pixelatedknight27/PIC18/README.md

# A PIC18 development board
### Based off of Professor Felix Pinai's ECE3301L board
