pixelatedknight27/PIC18/ExternFootprints/DILB40P-223TLF/PIC18F452-E_P.STEP

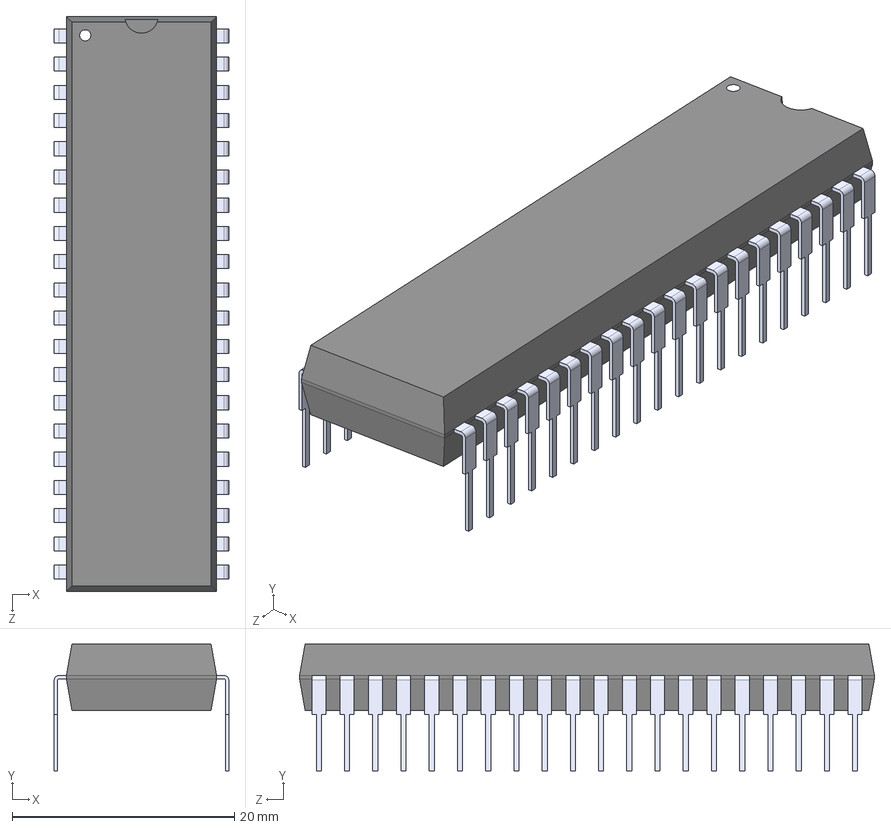
[picture p1: CAD file, 2024-06-22]
ExternFootprints/DILB40P-223TLF/PIC18F452-E_P.STEP
15.7 x 11.4 x 51.8 mm
