pixelatedknight27/PIC18/ExternFootprints/Jumpers/Jumper2-yellow.step

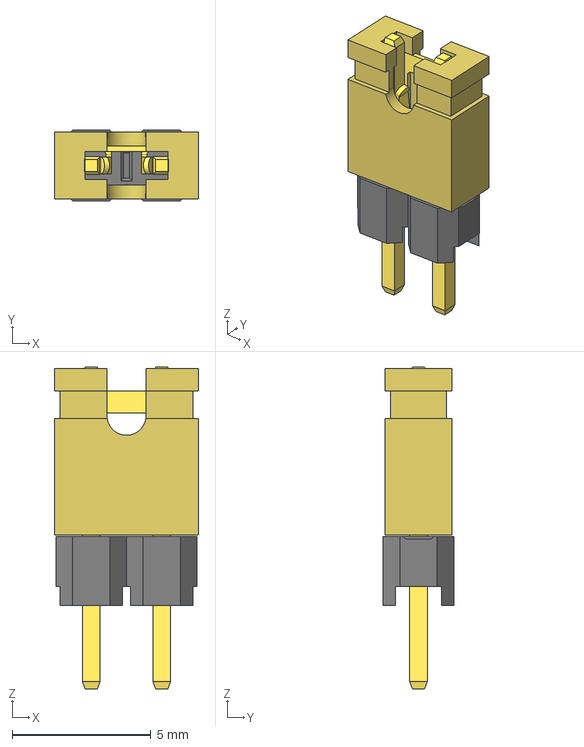
[picture p2: CAD file, 2024-06-23]
ExternFootprints/Jumpers/Jumper2-yellow.step
5.20 x 2.54 x 11.6 mm
