pixelatedknight27/PIC18/ExternFootprints/MF-MSMF200-2/MF-MSMF200-2.step

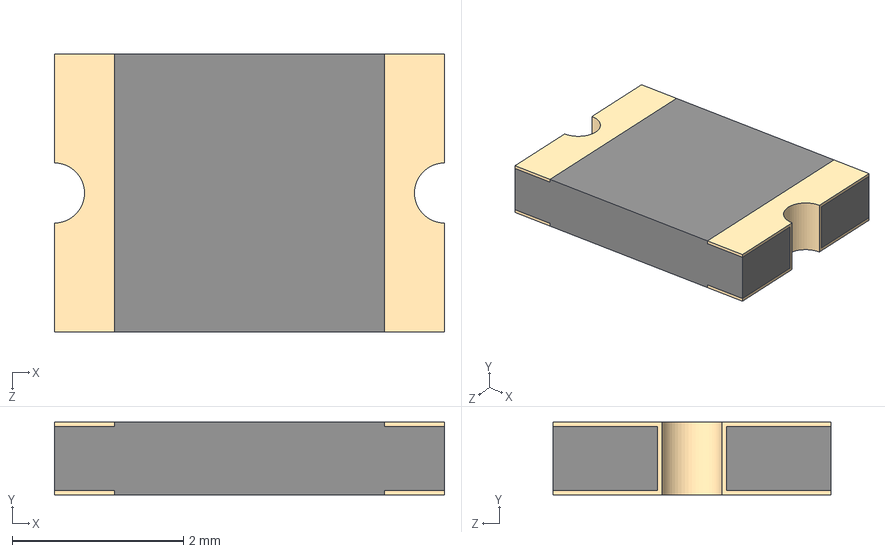
[picture p3: CAD file, 2024-06-23]
ExternFootprints/MF-MSMF200-2/MF-MSMF200-2.step
4.55 x 0.85 x 3.24 mm
