pixelatedknight27/PIC18/ExternFootprints/YC124-JR-071RL/YC124-JR-071RL.step

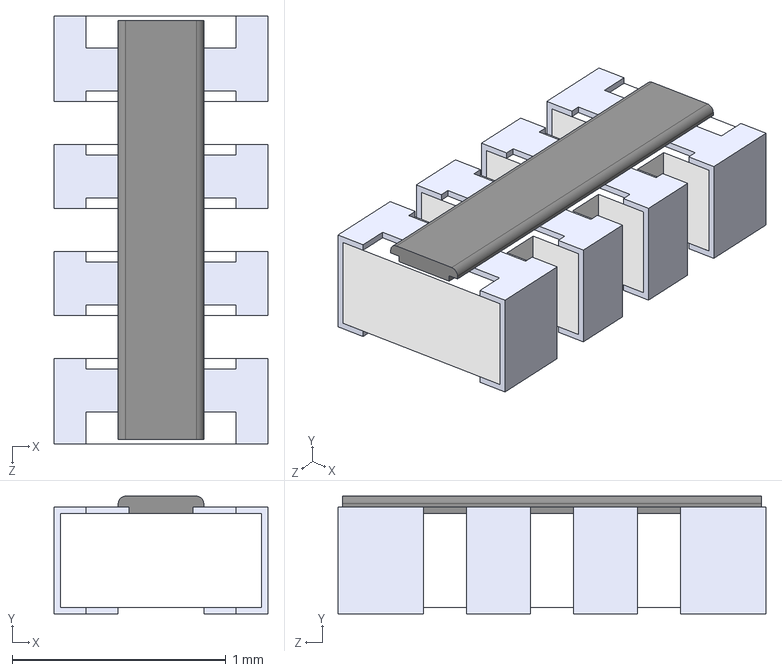
[picture p4: CAD file, 2024-07-10]
ExternFootprints/YC124-JR-071RL/YC124-JR-071RL.step
1.00 x 0.55 x 2.00 mm
