pixelatedknight27/PIC18/ExternFootprints/ZM4748A_L0G/ZM4748A_L0G.step

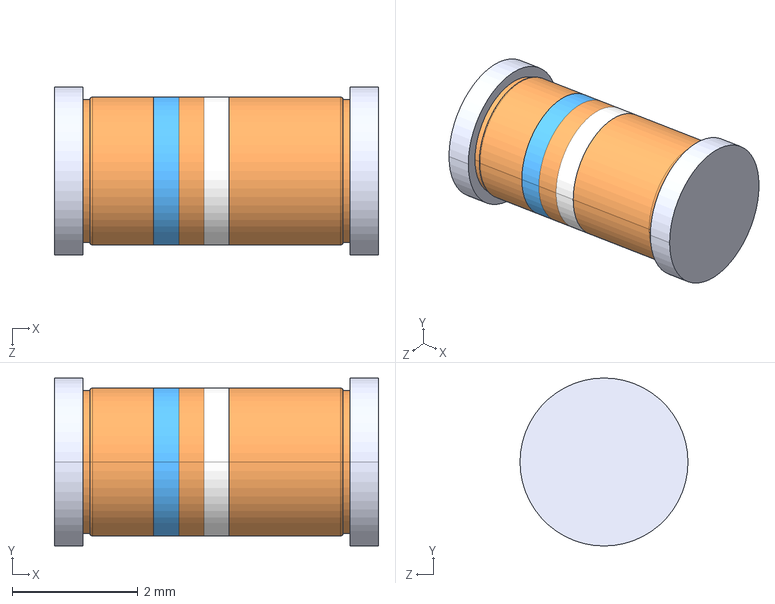
[picture p5: CAD file, 2024-06-23]
ExternFootprints/ZM4748A_L0G/ZM4748A_L0G.step
5.15 x 2.67 x 2.67 mm
