pixelatedknight27/PIC18/ExternFootprints/DILB40P-223TLF/DILB40P-223TLF.step

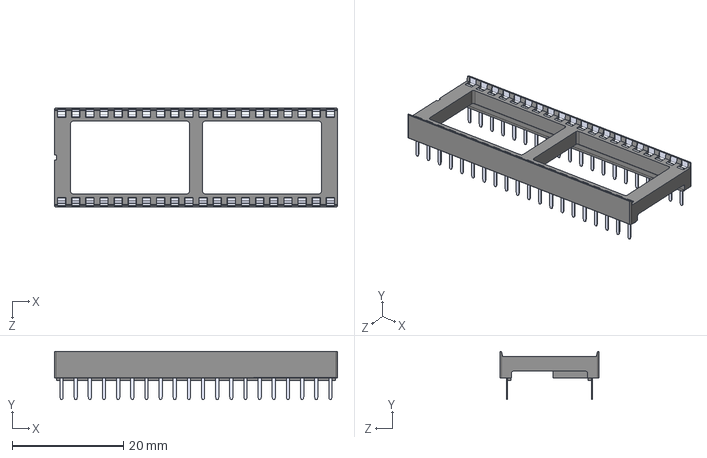
[picture p6: CAD file, 2024-06-22]
ExternFootprints/DILB40P-223TLF/DILB40P-223TLF.step
50.8 x 8.70 x 17.8 mm
