pixelatedknight27/PIC18/ExternFootprints/Jumpers/Jumper-blue.step

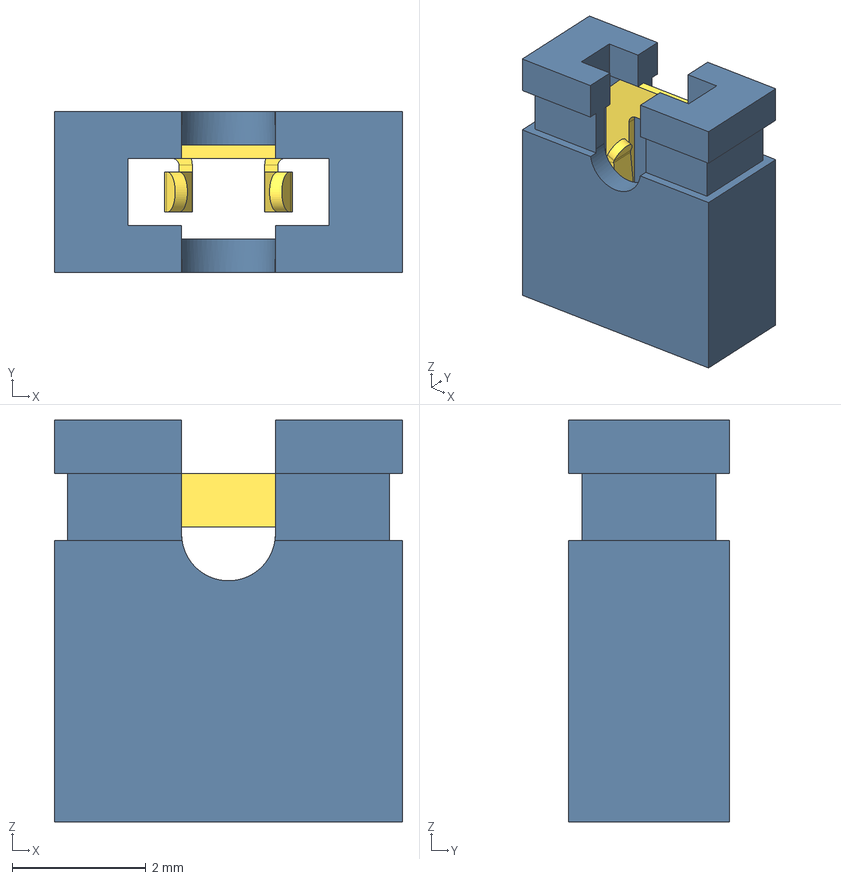
[picture p7: CAD file, 2024-06-23]
ExternFootprints/Jumpers/Jumper-blue.step
5.20 x 2.40 x 6.00 mm
