pixelatedknight27/PIC18/ExternFootprints/Jumpers/Jumper3-blue.step

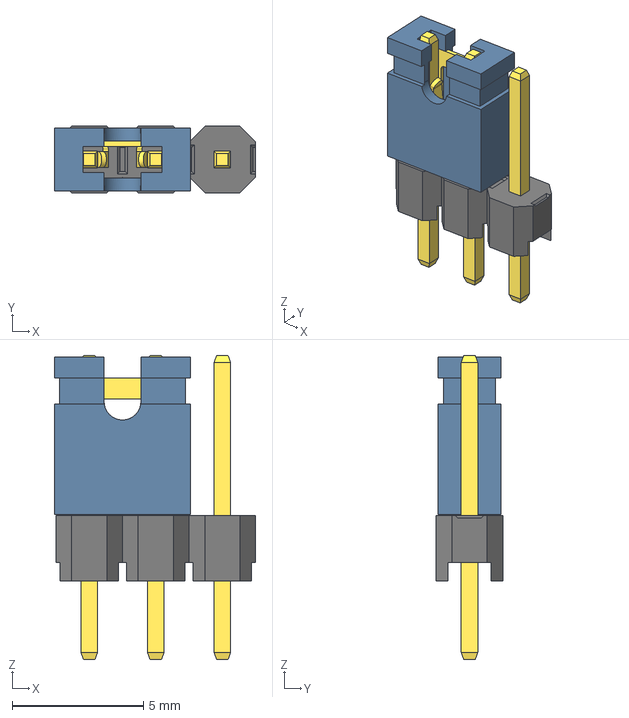
[picture p8: CAD file, 2024-06-23]
ExternFootprints/Jumpers/Jumper3-blue.step
7.68 x 2.54 x 11.6 mm
