pixelatedknight27/PIC18/(list of files, cad)

Other CAD files:
ExternFootprints/Jumpers/Jumper.step
ExternFootprints/Jumpers/Jumper-red.step
ExternFootprints/Jumpers/Jumper2.step
ExternFootprints/Jumpers/Jumper3.step
ExternFootprints/Jumpers/Jumper3-yellow.step
ExternFootprints/Jumpers/Jumper2-red.step
ExternFootprints/Jumpers/Jumper2-blue.step
ExternFootprints/Jumpers/Jumper-green.step
ExternFootprints/Jumpers/Jumper-yellow.step
ExternFootprints/Jumpers/Jumper2-green.step
ExternFootprints/Jumpers/Jumper3-green.step
ExternFootprints/Jumpers/Jumper3-red.step
ExternFootprints/MOLEX_105164-0001/105164-0001.step
ExternFootprints/ul_676433910/676433910.stp
