pixelatedknight27/PIC18/(list of files, drawings)

Other design files:
freerouting.dsn
