pixelatedknight27/PIC18/PIC18.kicad_pcb

## KiCad design PIC18.kicad_pcb (2024-08-14)

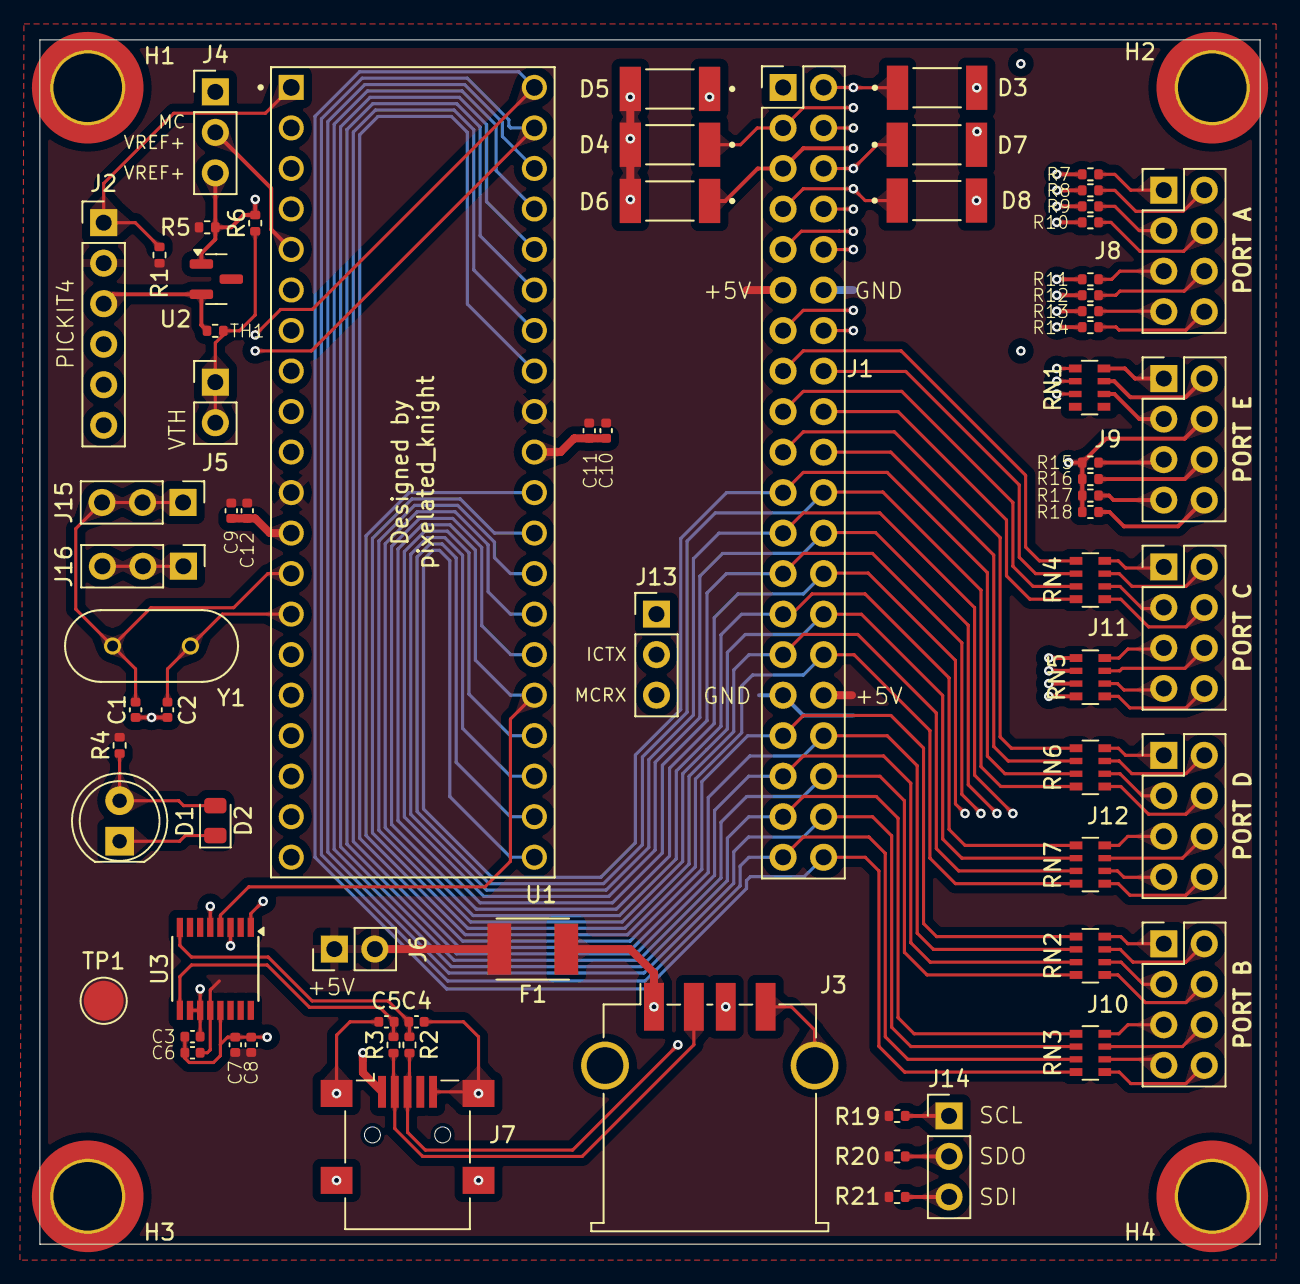
[picture p9: board PIC18.kicad_pcb from above]

Board: 4 copper layers, 76.5 x 75.5 mm, 75 parts (0 on the bottom side), 87 nets.

Parts:
C1, C2: 22pF; C_0402_1005Metric
C3, C6: 100nF; C_0402_1005Metric
C4, C5: 47pf; C_0402_1005Metric
C7: 4.7u; C_0402_1005Metric
C8, C10, C12: 100nf; C_0402_1005Metric
C9, C11: 1uf; C_0402_1005Metric
D1: LED; LED_D5.0mm
D2: LED; LED_0805_2012Metric
D3, D4, D5, D6, D7, D8: ZMM5V1; DIOMELF5124N
F1: MF-MSMF200-2; FUSER_MF-MSMF200-2
H1, H2, H3, H4: MountingHole_Pad; MountingHole_4.3mm_M4_ISO14580_Pad_TopBottom
J1: Conn_02x20_Odd_Even; PinSocket_2x20_Counter_Clockwise_P2.54mm_Vertical
J2: Conn_01x06; PinHeader_1x06_P2.54mm_Vertical
J3: USB_A; USB_A_TE_292303-7_Horizontal
J4, J13, J14, J15, J16: Conn_01x03; PinHeader_1x03_P2.54mm_Vertical
J5, J6: Conn_01x02; PinHeader_1x02_P2.54mm_Vertical
J7: USB_OTG; USB_Mini-B_Lumberg_2486_01_Horizontal
J8: Port A; PinHeader_2x04_P2.54mm_Vertical_Red
J9: Port E; PinHeader_2x04_P2.54mm_Vertical_Green
J10: Port B; PinHeader_2x04_P2.54mm_Vertical_Yellow
J11: Port C; PinHeader_2x04_P2.54mm_Vertical_Blue
J12: Port D; PinHeader_2x04_P2.54mm_Vertical_White
R1: 10K; R_0402_1005Metric
R2, R3, R5: 33; R_0402_1005Metric
R4, R6, R7, R8, R9, R10, R11, R12, R13, R14: 220; R_0402_1005Metric
R15: 100; R_0402_1005Metric
R16: 1k; R_0402_1005Metric
R17, R19, R20, R21: 10k; R_0402_1005Metric
R18: 100k; R_0402_1005Metric
RN1, RN2, RN3, RN4, RN5, RN6, RN7: 220; R_Array_Convex_4x0603
TH1: 10k; R_0402_1005Metric
TP1: TestPoint; TestPoint_Pad_D2.5mm
U1: PIC18F4620; AMPHENOL_DILB40P-223TLF
U2: LM4040DBZ-4.1; SOT-23
U3: FT230XS; SSOP-16_3.9x4.9mm_P0.635mm
Y1: 8 MHz; XTAL_HC49P488W43L1085T450H368

Connections:
/*MCLR/VPP/RE3: J1.1, J2.1, R1.2, U1.1 (*MCLR/VPP/RE3)
/OSC1/CLKI/RA7: C1.2, J1.13, J15.1, J15.2, J15.3, R13.1, U1.13 (OSC1/CLKI/RA7), Y1.2
/OSC2/CLKO/RA6: C2.2, J1.14, J16.1, J16.2, J16.3, R14.1, U1.14 (OSC2/CLKO/RA6), Y1.1
/RA0/AN0: D3.1 (K), J1.2, R7.1, U1.2 (RA0/AN0)
/RA1/AN1: D4.1 (K), J1.3, R8.1, U1.3 (RA1/AN1)
/RA2/AN2/VREF-/CVREF: D5.1 (K), J1.4, R9.1, U1.4 (RA2/AN2/VREF-/CVREF)
/RA3/AN3/VREF+: D6.1 (K), J1.5, J4.2, R10.1, U1.5 (RA3/AN3/VREF+)
/RA4/T0CKI/C1OUT: D7.1 (K), J1.6, R11.1, U1.6 (RA4/T0CKI/C1OUT)
/RA5/AN4/SS*/HLVDIN/C2OUT: D8.1 (K), J1.7, R12.1, U1.7 (RA5/AN4/SS*/HLVDIN/C2OUT)
/RB0/INT0/FLT0/AN12: J1.33, RN2.5 (R4.2), U1.33 (RB0/INT0/FLT0/AN12)
/RB1/INT1/AN10: J1.34, RN2.6 (R3.2), U1.34 (RB1/INT1/AN10)
/RB2/INT2/AN8: J1.35, RN2.7 (R2.2), U1.35 (RB2/INT2/AN8)
/RB3/AN9/CCP2(1): J1.36, RN2.8 (R1.2), U1.36 (RB3/AN9/CCP2(1))
/RB4/KBI0/AN11: J1.37, RN3.5 (R4.2), U1.37 (RB4/KBI0/AN11)
/RB5/KBI1/PGM: J1.38, RN3.6 (R3.2), U1.38 (RB5/KBI1/PGM)
/RB6/KBI2/PGC: J1.39, J2.5, RN3.7 (R2.2), U1.39 (RB6/KBI2/PGC)
/RB7/KBI3/PGD: J1.40, J2.4, RN3.8 (R1.2), U1.40 (RB7/KBI3/PGD)
/RC0/T1OSO/T13CKI: J1.15, RN4.5 (R4.2), U1.15 (RC0/T1OSO/T13CKI)
/RC1/T1OSI/CCP2(1): J1.16, RN4.6 (R3.2), U1.16 (RC1/T1OSI/CCP2(1))
/RC2/CCP1/P1A: J1.17, RN4.7 (R2.2), U1.17 (RC2/CCP1/P1A)
/RC3/SCK/SCL: J1.18, J14.1, R19.2, RN4.8 (R1.2), U1.18 (RC3/SCK/SCL)
/RC4/SDI/SDA: J1.23, J14.3, R21.2, RN5.5 (R4.2), U1.23 (RC4/SDI/SDA)
/RC5/SDO: J1.24, J14.2, R20.2, RN5.6 (R3.2), U1.24 (RC5/SDO)
/RC6/TX/CK: J1.25, RN5.7 (R2.2), U1.25 (RC6/TX/CK), U3.4 (RXD)
/RC7/RX/DT: J1.26, J13.3, RN5.8 (R1.2), U1.26 (RC7/RX/DT)
/RD0/PSP0: J1.19, RN6.5 (R4.2), U1.19 (RD0/PSP0)
/RD1/PSP1: J1.20, RN6.6 (R3.2), U1.20 (RD1/PSP1)
/RD2/PSP2: J1.21, RN6.7 (R2.2), U1.21 (RD2/PSP2)
/RD3/PSP3: J1.22, RN6.8 (R1.2), U1.22 (RD3/PSP3)
/RD4/PSP4: J1.27, RN7.5 (R4.2), U1.27 (RD4/PSP4)
/RD5/PSP5/P1B: J1.28, RN7.6 (R3.2), U1.28 (RD5/PSP5/P1B)
/RD6/PSP6/P1C: J1.29, RN7.7 (R2.2), U1.29 (RD6/PSP6/P1C)
/RD7/PSP7/P1D: J1.30, RN7.8 (R1.2), U1.30 (RD7/PSP7/P1D)
/RE0/RD*/AN5: J1.8, RN1.5 (R4.2), U1.8 (RE0/RD*/AN5)
/RE1/WR*/AN6: J1.9, RN1.6 (R3.2), U1.9 (RE1/WR*/AN6)
/RE2/CS*/AN7: J1.10, RN1.7 (R2.2), U1.10 (RE2/CS*/AN7)
/TXD: J13.2, U3.1 (TXD)
/VREF+: J4.3, J9.4, R5.2, R6.2, R15.1, R16.1, R17.1, R18.1, U2.1 (K)
/VTHERM: J5.1, J5.2, R6.1, TH1.1
GND: C1.1, C2.1, C3.2, C4.2, C5.2, C6.2, C7.2, C8.1, C9.1, C10.1, C11.1, C12.1, D1.1 (K), D2.1 (K), D3.2 (A), D4.2 (A), D5.2 (A), D6.2 (A), D7.2 (A), D8.2 (A), H1.1, H2.1, H3.1, H4.1, J1.12, J1.31, J2.3, J3.4 (GND), J3.5 (Shield), J7.5 (GND), J7.6 (Shield), TH1.2, U1.12 (VSS), U1.31 (VSS), U2.2 (A), U3.5 (GND), U3.13 (GND)
unnamed: D1.2 (A), D2.2 (A), R4.1
unnamed: J3.3 (D+), J7.3 (D+), R2.1
unnamed: J3.2 (D-), J7.2 (D-), R3.1
unnamed: F1.1, J3.1 (VBUS), J7.1 (VBUS)
unnamed: J8.1, R7.2
unnamed: J8.2, R8.2
unnamed: J8.3, R9.2
unnamed: J8.4, R10.2
unnamed: J8.5, R11.2
unnamed: J8.6, R12.2
unnamed: J8.7, R13.2
unnamed: J8.8, R14.2
unnamed: J9.1, RN1.4 (R4.1)
unnamed: J9.2, RN1.3 (R3.1)
unnamed: J9.3, RN1.2 (R2.1)
unnamed: J9.5, R15.2
unnamed: J9.6, R16.2
unnamed: J9.7, R17.2
unnamed: J9.8, R18.2
unnamed: J10.1, RN2.4 (R4.1)
unnamed: J10.2, RN2.3 (R3.1)
unnamed: J10.3, RN2.2 (R2.1)
unnamed: J10.4, RN2.1 (R1.1)
unnamed: J10.5, RN3.4 (R4.1)
unnamed: J10.6, RN3.3 (R3.1)
unnamed: J10.7, RN3.2 (R2.1)
unnamed: J10.8, RN3.1 (R1.1)
unnamed: J11.1, RN4.4 (R4.1)
unnamed: J11.2, RN4.3 (R3.1)
unnamed: J11.3, RN4.2 (R2.1)
unnamed: J11.4, RN4.1 (R1.1)
unnamed: J11.5, RN5.4 (R4.1)
unnamed: J11.6, RN5.3 (R3.1)
unnamed: J11.7, RN5.2 (R2.1)
unnamed: J11.8, RN5.1 (R1.1)
unnamed: J12.1, RN6.4 (R4.1)
unnamed: J12.2, RN6.3 (R3.1)
unnamed: J12.3, RN6.2 (R2.1)
unnamed: J12.4, RN6.1 (R1.1)
unnamed: J12.5, RN7.4 (R4.1)
unnamed: J12.6, RN7.3 (R3.1)
unnamed: J12.7, RN7.2 (R2.1)
unnamed: J12.8, RN7.1 (R1.1)
unnamed: C3.1, U3.3 (VCCIO), U3.10 (3V3OUT), U3.11 (~RESET)
unnamed: C5.1, R3.2, U3.9 (USBDM)
unnamed: C4.1, R2.2, U3.8 (USBDP)
VCC: C6.1, C7.1, C8.2, C9.2, C10.2, C11.2, C12.2, F1.2, J1.11, J1.32, J2.2, J6.1, J6.2, R1.1, R4.2, R5.1, R19.1, R20.1, R21.1, TP1.1, U1.11 (VDD), U1.32 (VDD), U3.12 (VCC)
