pixelatedknight27/PIC18/(commit log)

2024-06-22 footprint and step assignment
    [ATS08A-E.step, DILB40P-223TLF.step, PIC18.kicad_pcb, PIC18.kicad_sch, PIC18F452-E_P.STEP]
2024-06-23 More footprint assignments
    [676433910.stp, MF-MSMF200-2.step, PIC18.kicad_sch]
2024-06-23 yet more footprint assignment
    [105164-0001.step, PIC18.kicad_pcb, PIC18.kicad_sch]
2024-06-23 added Zener and colored pin headers
    [Jumper-blue.step, Jumper-green.step, Jumper-red.step, Jumper-yellow.step, Jumper.step, Jumper2-blue.step, Jumper2-green.step, Jumper2-red.step]
2024-06-29 Updated schematic
    [PIC18.kicad_sch]
2024-06-30 finishing touches on schematic
2024-06-30 More updates
    [PIC18.kicad_pcb, PIC18.kicad_sch]
2024-06-30 lots of changes
    [bom.csv, designators.csv, positions.csv]
2024-06-30 Schematic edit
    [PIC18.kicad_pcb, PIC18.kicad_sch]
2024-07-01 Silkscreen edits
    [PIC18.kicad_pcb]
2024-07-01 Back to 2 layers
    [PIC18.kicad_pcb]
2024-07-01 Header routing
    [PIC18.kicad_pcb]
2024-07-01 More routing
    [PIC18.kicad_pcb]
2024-07-04 PCB edit
    [PIC18.kicad_pcb]
2024-07-05 Header Wiring
    [PIC18.kicad_pcb]
2024-07-05 All main wiring done
    [PIC18.kicad_pcb, PIC18.kicad_sch]
2024-07-05 Edited PCB
    [PIC18.kicad_pcb]
2024-07-07 JLCPCB parody edits
    [PIC18.kicad_pcb, PIC18.kicad_sch, bom.csv]
2024-07-10 more jlcpcb parody
    [PIC18.kicad_pcb, PIC18.kicad_sch, YC124-JR-071RL.step, bom.csv, positions.csv]
2024-07-12 Changed main pin header to pin socket
    [PIC18.kicad_pcb, PIC18.kicad_sch]
2024-08-14 fixed port B
    [PIC18.kicad_pcb, PIC18.kicad_sch]
